Fabreeko/Zero-G-Carbonara-/README.md

# Zero-G-Carbonara-
CAD Files for the Lightweight Carbonara Gantry Bar for the Zero G Mercury

Top mounted toolheads such as Eva will need modifications.  You may need to use shims under the screw heads, or grind the bolts to be slightly shorter, or add clearance to printed parts.
