Fabreeko/Zero-G-Carbonara-/Mercury 370 Carbonara Options.step

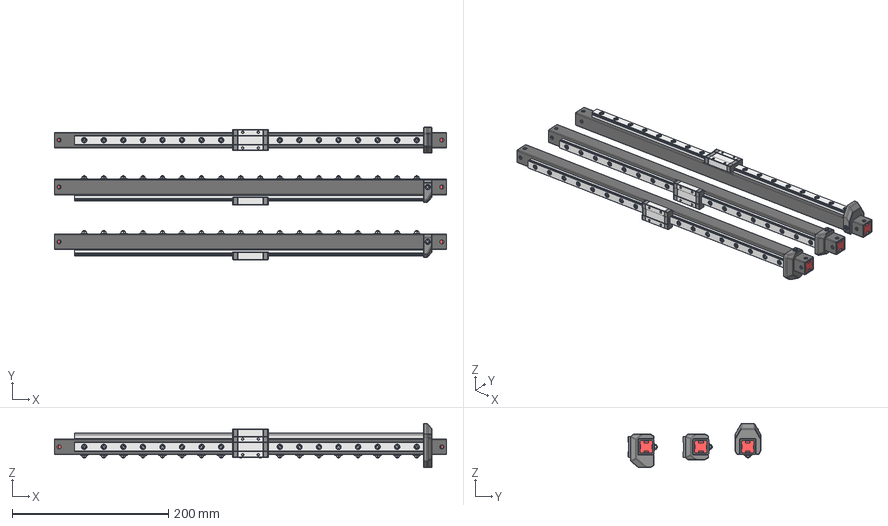
[picture p2: CAD file, 2026-04-23]
Mercury 370 Carbonara Options.step
501.0 x 169.5 x 56.6 mm
Rail x 3
MGN12H x 3
M5 insert x 2
Helper tube x 17
M3 insert x 16
M5 Hex Nut v1 x 4
M3x28 SHCS x 18
M3 Washer x 18
M3_Hexnut x 18
M3x30 SHCS
M3 x D5 x L4 Heatset
M5 insert_1 x 4
Helper tube_1 x 34
M3 insert_1 x 32
M5 Hex Nut v1_1 x 8
M3x28 SHCS_1 x 36
M3 Washer_1 x 36
M3_Hexnut_1 x 36
M3x30 SHCS_1
M3 x D5 x L4 Heatset_1 x 2
M3x40 SHCS
